jintai522/ME101_Wall-E/LINK TO ALL PARTS.txt

https://kb.vex.com/hc/en-us/articles/360044338912-CAD-Resources-for-VEX-IQ
