jintai522/ME101_Wall-E/PART LISTS.txt

https://www.vexrobotics.com/parts/228-7755?srsltid=AfmBOor7yfZhFB1WJDb23lGK7N8fuW8yRwTyhvqO8oEq8ajA6IASuBJW
