jintai522/ME101_Wall-E/Jintai Files/Scooperv1.SLDPRT

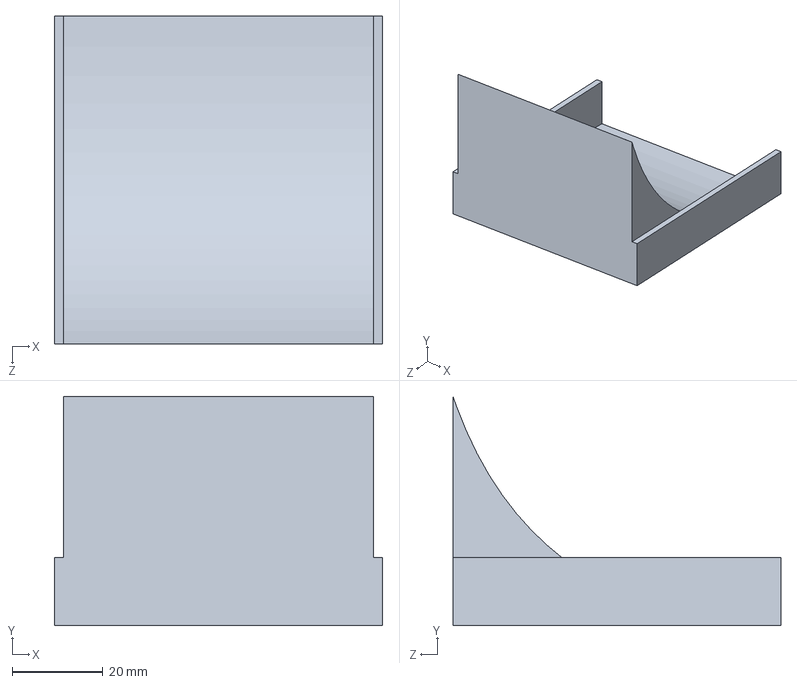
[picture p1: CAD file, 2026-07-04]
Jintai Files/Scooperv1.SLDPRT
72.2 x 50.5 x 72.2 mm
