jintai522/ME101_Wall-E/Jintai Files/straight bevel pinion_am11111.SLDPRT

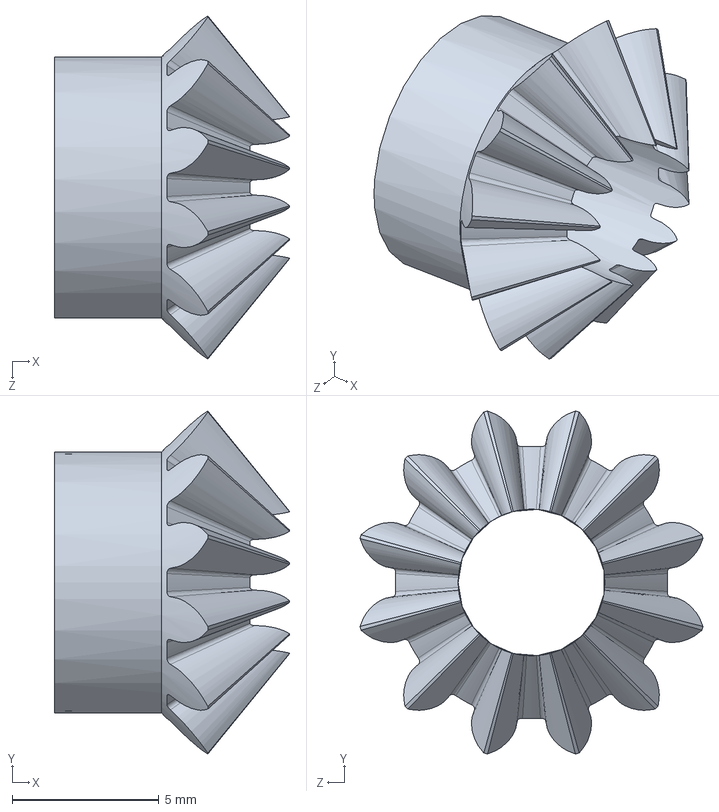
[picture p2: CAD file, 2026-07-04]
Jintai Files/straight bevel pinion_am11111.SLDPRT
8.03 x 11.7 x 11.7 mm
