jintai522/ME101_Wall-E/Jintai Files/box.SLDPRT

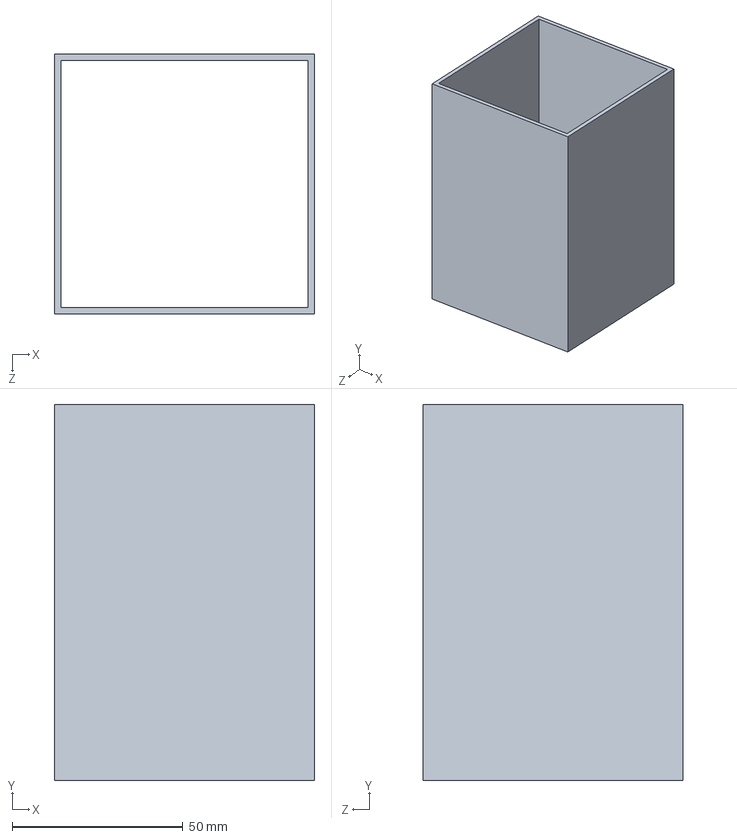
[picture p3: CAD file, 2026-07-01]
Jintai Files/box.SLDPRT
76.2 x 110.0 x 76.2 mm
