jintai522/ME101_Wall-E/Jintai Files/just arms.SLDASM

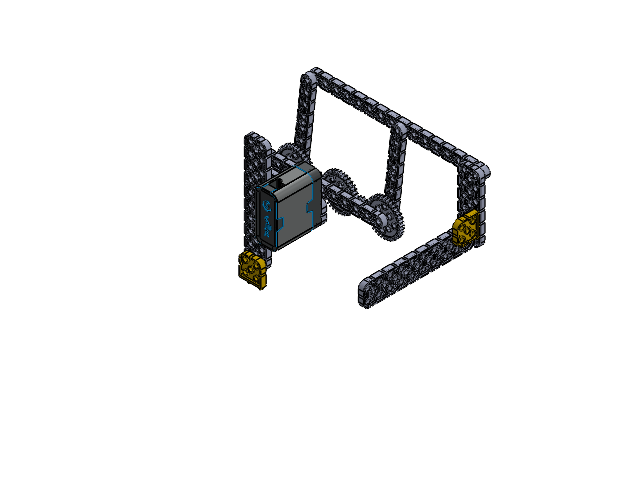
[picture p4: CAD file, 2026-07-08]
Jintai Files/just arms.SLDASM
1x12 Beam (228-2500-011).step
36 Tooth Gear (228-2500-214).step x 3
12 Tooth Gear (228-2500-213).step x 2
1x16 Beam (228-2500-014).step
2x6 Beam (228-2500-021).step x 2
1x8 Beam (228-2500-007).step x 2
2x Wide, 2x2 Corner Connector (Weak) (228-2500-2295).step x 2
2x10 Beam (228-2500-025).step x 2
VEX IQ Smart Motor (228-2560).step
