jintai522/ME101_Wall-E/Jintai Files/Vex+Gears+scooper+sidegear + arm - Copy.SLDASM

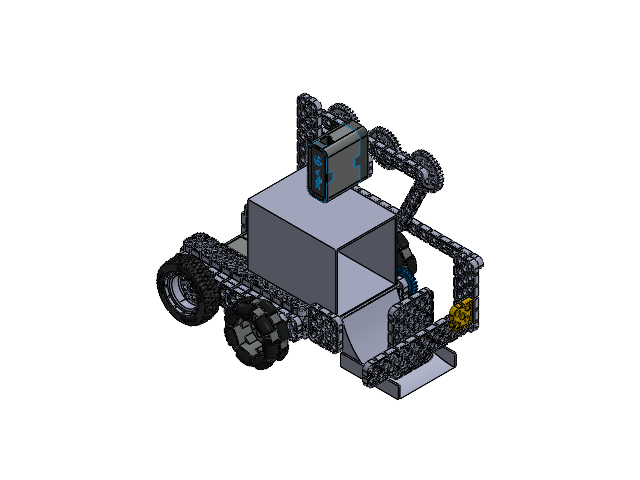
[picture p5: CAD file, 2026-07-08]
Jintai Files/Vex+Gears+scooper+sidegear + arm - Copy.SLDASM
2x12 Beam (228-2500-026).step x 4
Triple 2x Wide, 2x2 Corner Connector (228-2500-1253).step x 6
2x10 Beam (228-2500-025).step x 6
VEX IQ Smart Motor (228-2560).step x 4
2x6 Beam (228-2500-021).step x 3
Small Wheel Hub (44 mm) (228-2500-1208).step x 2
Tire (200 mm Travel) (228-2500-209).step x 2
228-2536-004-1.step x 28
228-2536-003-1.step x 28
228-2536-002-1.step x 28
228-2536-001-1.step x 2
2x2 Beam (228-2500-017).step x 2
VEX IQ Optical Sensor (228-7082).step x 2
2x Pitch Capped Shaft (228-2500-2219).step x 2
2x Wide, 2x2 Corner Connector (Weak) (228-2500-2295).step x 4
Scooperv1
3x3 Plate (228-2500-031).step x 2
12 Tooth Gear (228-2500-213).step x 4
24 Tooth Gear (228-2500-227).step
8x Pitch Capped Shaft (228-2500-2228).step
straight bevel pinion_am x 2
1x12 Beam (228-2500-011).step
36 Tooth Gear (228-2500-214).step x 3
1x16 Beam (228-2500-014).step
1x8 Beam (228-2500-007).step x 2
4x6 Plate (228-2500-042).step
