jintai522/ME101_Wall-E/Jintai Files/WALLE_BASE.SLDASM

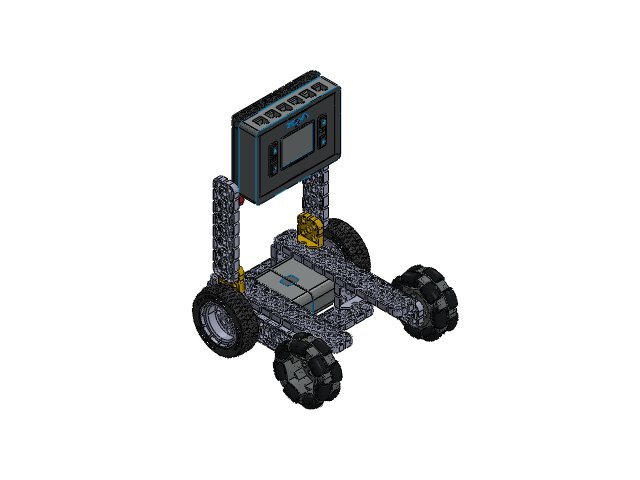
[picture p6: CAD file, 2026-07-06]
Jintai Files/WALLE_BASE.SLDASM
2x12 Beam (228-2500-026).step x 4
VEX IQ Smart Motor (228-2560).step x 2
Small Wheel Hub (44 mm) (228-2500-208).step x 2
Tire (200 mm Travel) (228-2500-209).step x 2
2x8 Beam (228-2500-023).step x 4
Triple 2x Wide, 2x2 Corner Connector (228-2500-1253).step x 4
2x Wide, 2x2 Corner Connector (Weak) (228-2500-2295).step x 2
228-2536-004-1.step x 14
228-2536-003-1.step x 14
228-2536-002-1.step x 14
228-2536-001-1.step
VEX IQ Robot Brain Gen 2 (228-6480).step
1x Wide, 1x1 Corner Connector (Weak) (228-2500-2288).step x 2
