jintai522/ME101_Wall-E/Jintai Files/justbasevex(rebuilt).SLDASM

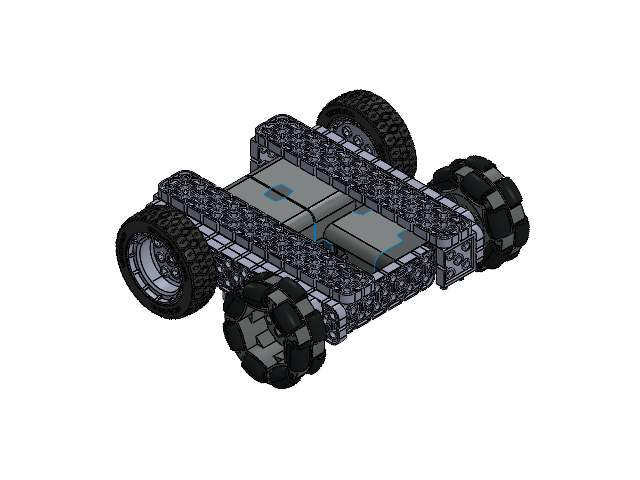
[picture p7: CAD file, 2026-07-04]
Jintai Files/justbasevex(rebuilt).SLDASM
2x12 Beam (228-2500-026).step x 4
Triple 2x Wide, 2x2 Corner Connector (228-2500-1253).step x 6
2x10 Beam (228-2500-025).step x 4
VEX IQ Smart Motor (228-2560).step x 3
2x6 Beam (228-2500-021).step
Small Wheel Hub (44 mm) (228-2500-1208).step x 2
Tire (200 mm Travel) (228-2500-209).step x 2
228-2536-004-1.step x 28
228-2536-003-1.step x 28
228-2536-002-1.step x 28
228-2536-001-1.step x 2
2x2 Beam (228-2500-017).step
VEX IQ Optical Sensor (228-7082).step
