jintai522/ME101_Wall-E/(list of files, cad)

Other CAD files:
Jintai Files/ROLLER-2_1.step.SLDASM
