jintai522/ME101_Wall-E/Design review 1 - Group #20.pdf

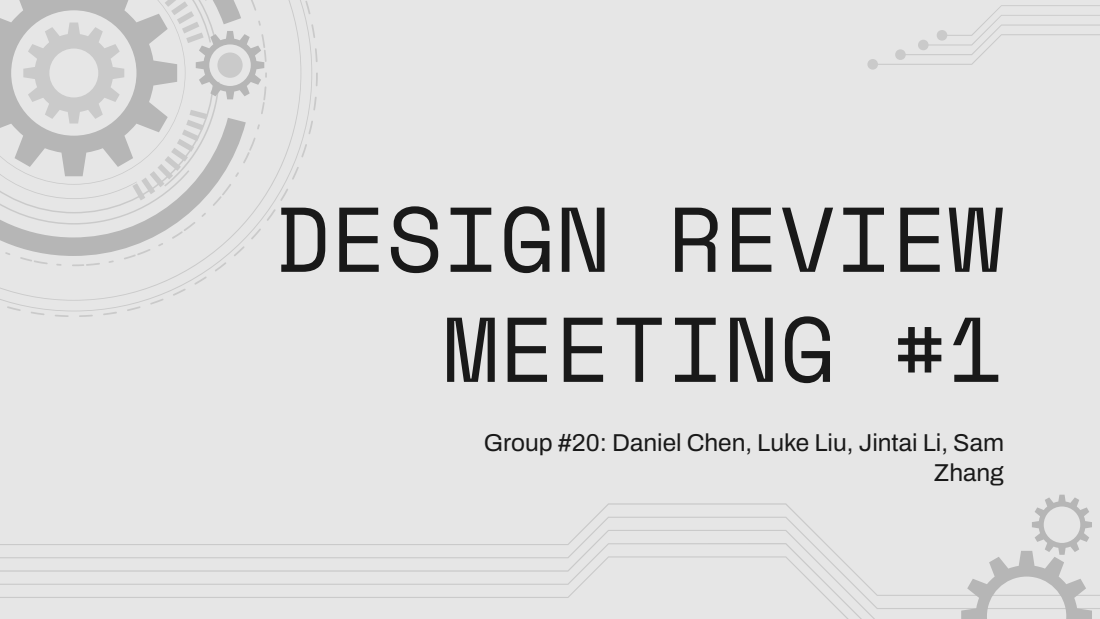
[picture p9: page 1]
DESIGN REVIEW MEETING #1; Zhang

Group #20: Daniel Chen, Luke Liu, Jintai Li, Sam

# TABLE OF CONTENTS

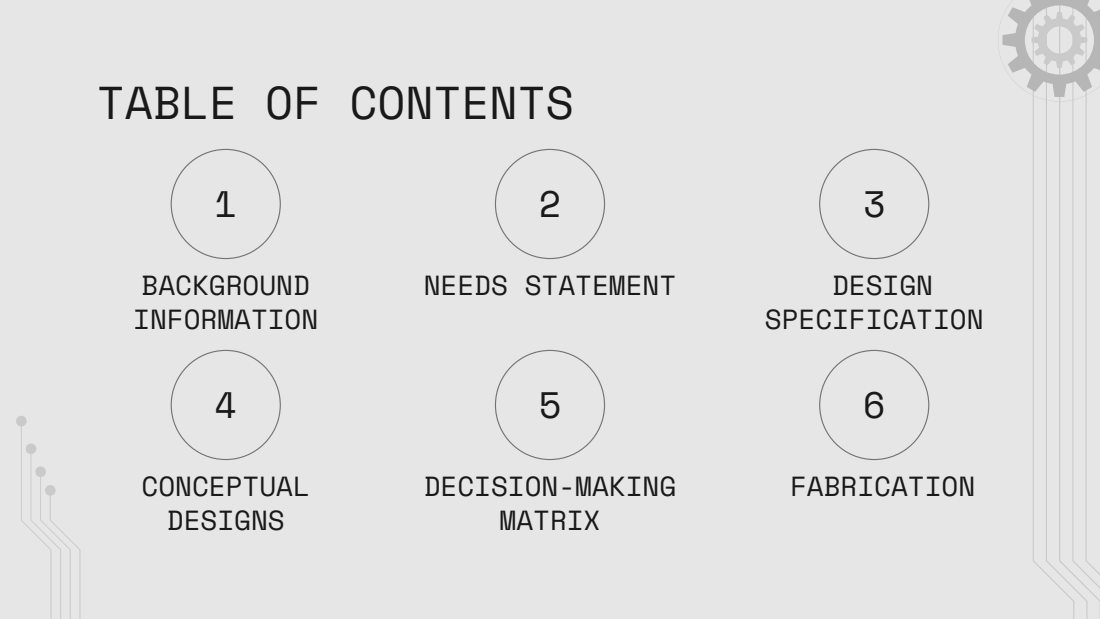
[picture p10: page 2]
BACKGROUND INFORMATION; NEEDS STATEMENT; CONCEPTUAL DESIGNS; DECISION-MAKING MATRIX; DESIGN SPECIFICATION; FABRICATION

# BACKGROUND INFORMATION

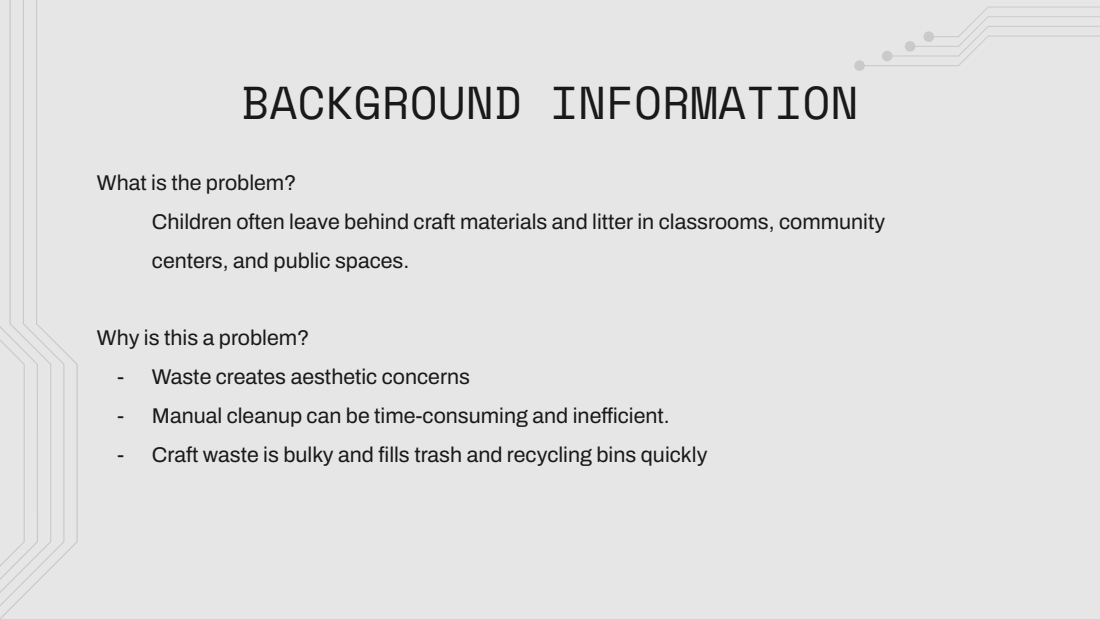
[picture p11: page 3]

What is the problem?
Children often leave behind craft materials and litter in classrooms, community
centers, and public spaces.

Why is this a problem?
- Waste creates aesthetic concerns
- Manual cleanup can be time-consuming and inefficient.
- Craft waste is bulky and fills trash and recycling bins quickly

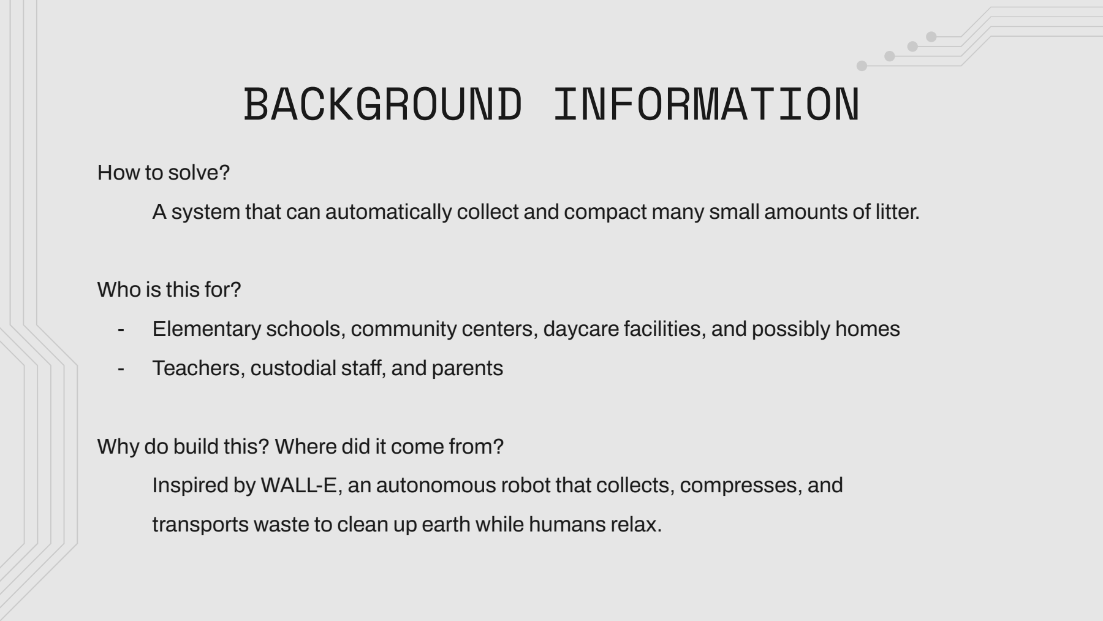
[picture p12: figure]
BACKGROUND INFORMATION; How to solve?; Who is this for?

A system that can automatically collect and compact many small amounts of litter.

- Elementary schools, community centers, daycare facilities, and possibly homes
- Teachers, custodial staff, and parents

Why do build this? Where did it come from?
Inspired by WALL-E, an autonomous robot that collects, compresses, and transports waste to clean up earth while humans relax.

# NEED STATEMENT

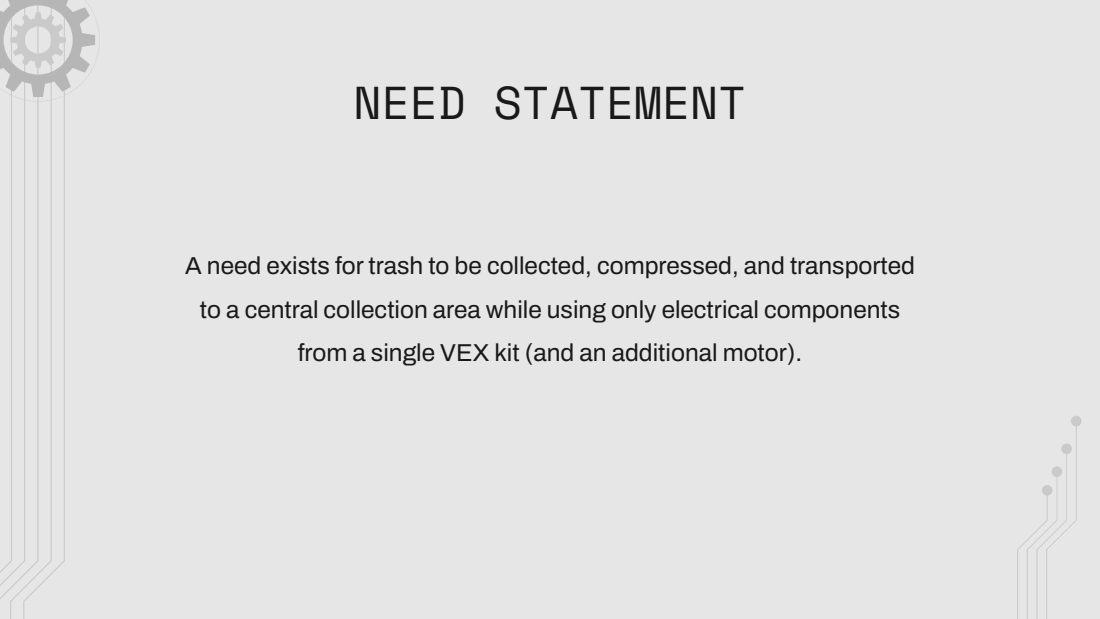
[picture p13: page 5]

A need exists for trash to be collected, compressed, and transported
to a central collection area while using only electrical components

from a single VEX kit (and an additional motor).

# DESIGN SPECIFICATIONS

No. | Characteristic | Relation | Value | Units | Verification Method | Comments
1 | Mass (Collected Trash) | >= | 10 | grams | Test | Trash will be scattered where the collected amount will be weighed on a scale.
2 | Volume reduction (After compression) | >= | 35 | % | Test | By measuring the width, length, and height of the cube before and after the compression, we can compare the volume of litter before and after and calculate % of volume reduced.
3 | Vote (Aesthetics) | >= | 70 | % | Test | Survey a minimum of 10 peers who have watched Wall-E and ask them if they can see the resemblance.
4 | Price | <= | 50 | CAD | Analysis | Calculate the total cost for the 3D printed parts (based on volume of model and cost per volume of filament), crafted parts, and bought parts.

# CONCEPTUAL DESIGNS

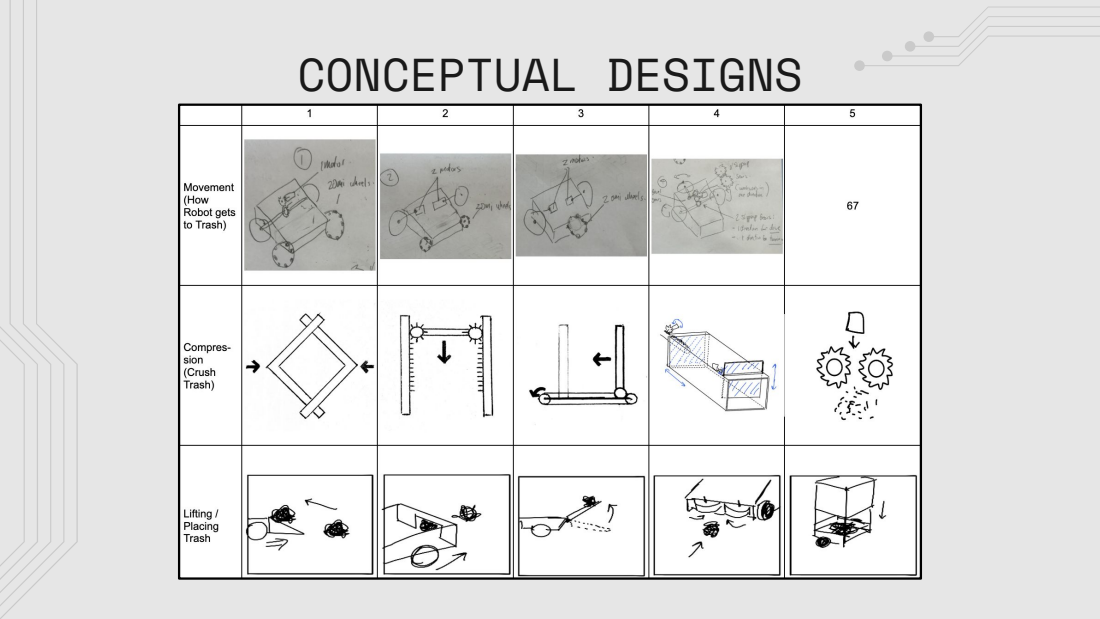
[picture p14: page 7]

# CONCEPTUAL DESIGNS (DATUM)

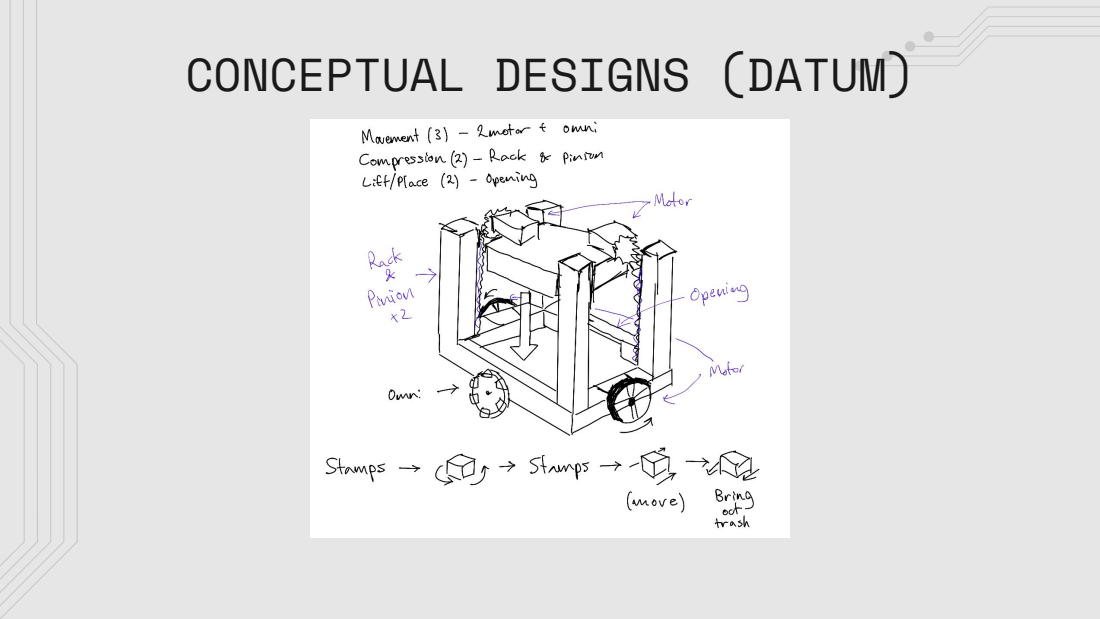
[picture p15: page 8]

# CONCEPTUAL DESIGNS #2

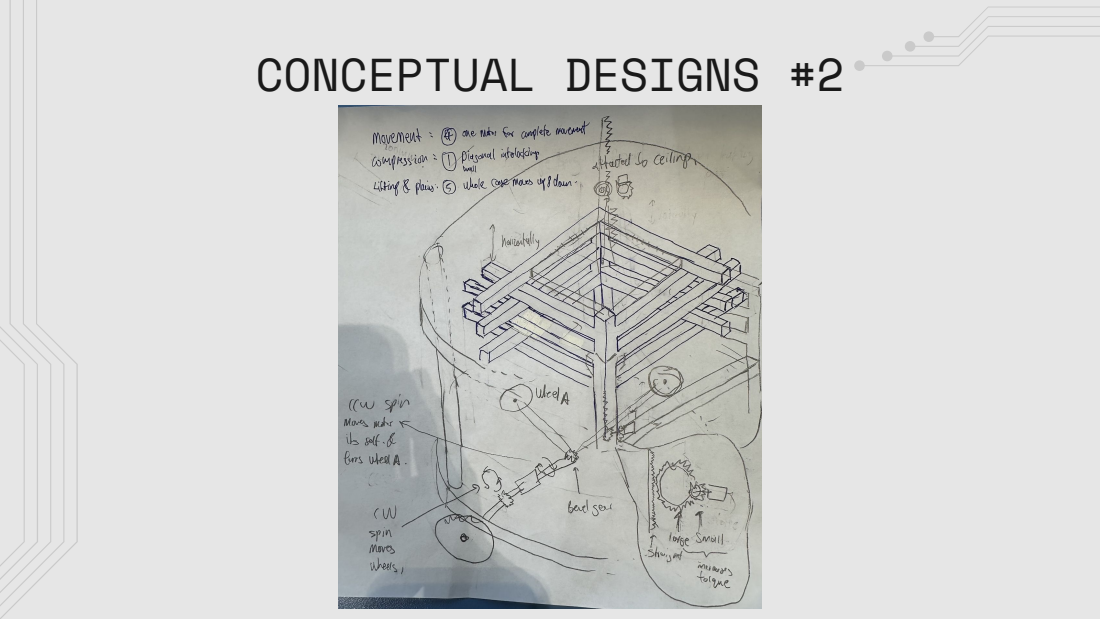
[picture p16: page 9]

# CONCEPTUAL DESIGNS #3

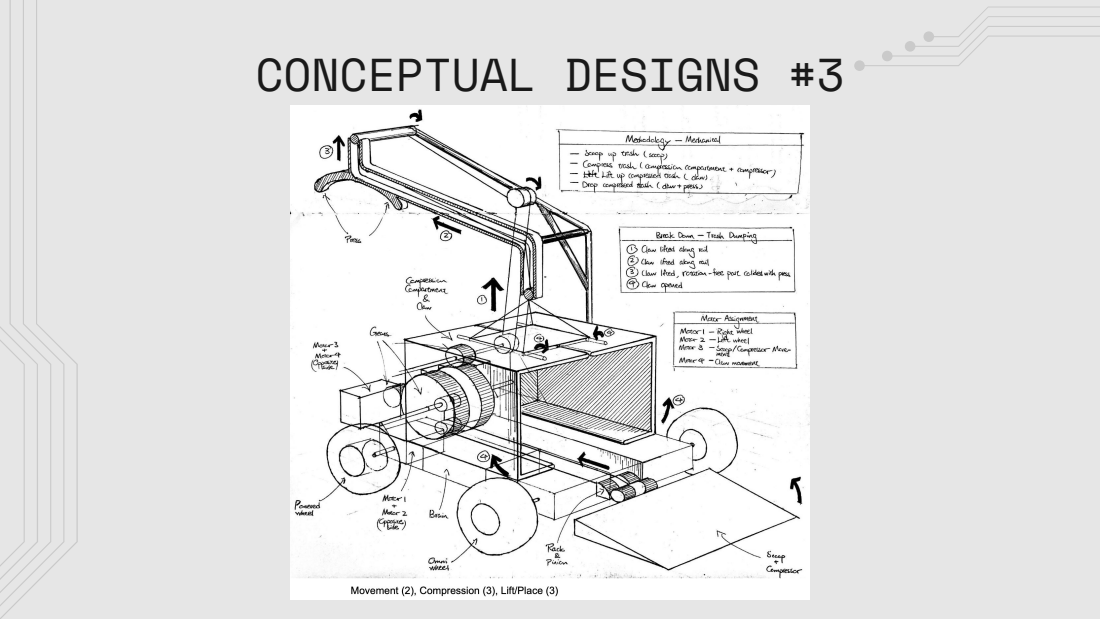
[picture p17: page 10]

# DECISION-MAKING MATRIX

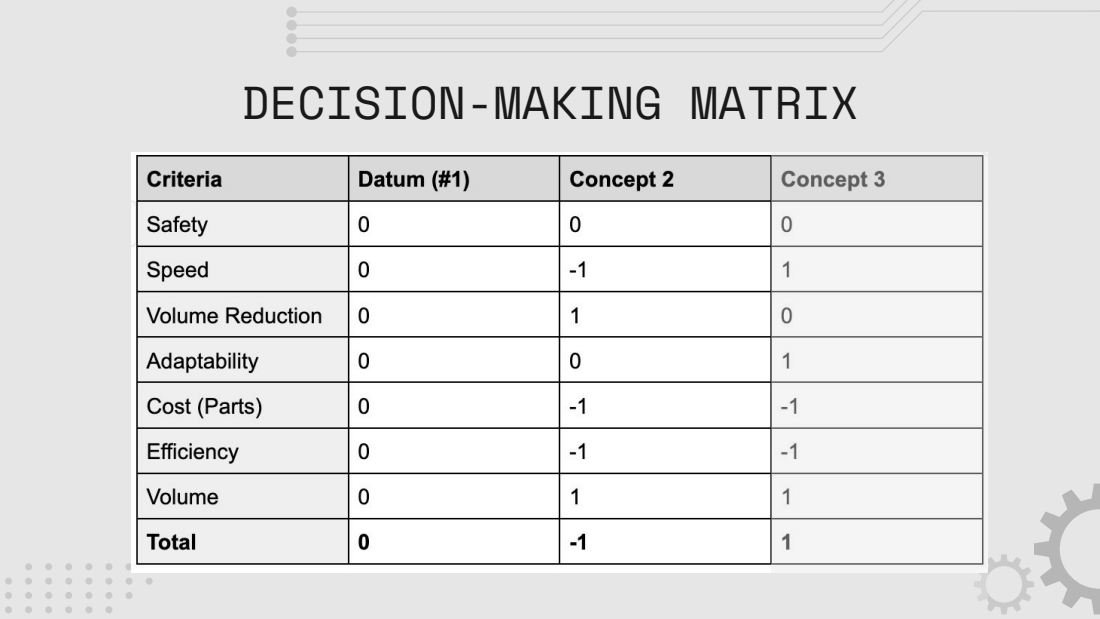
[picture p18: page 11]

# CONCEPTUAL DESIGNS #3

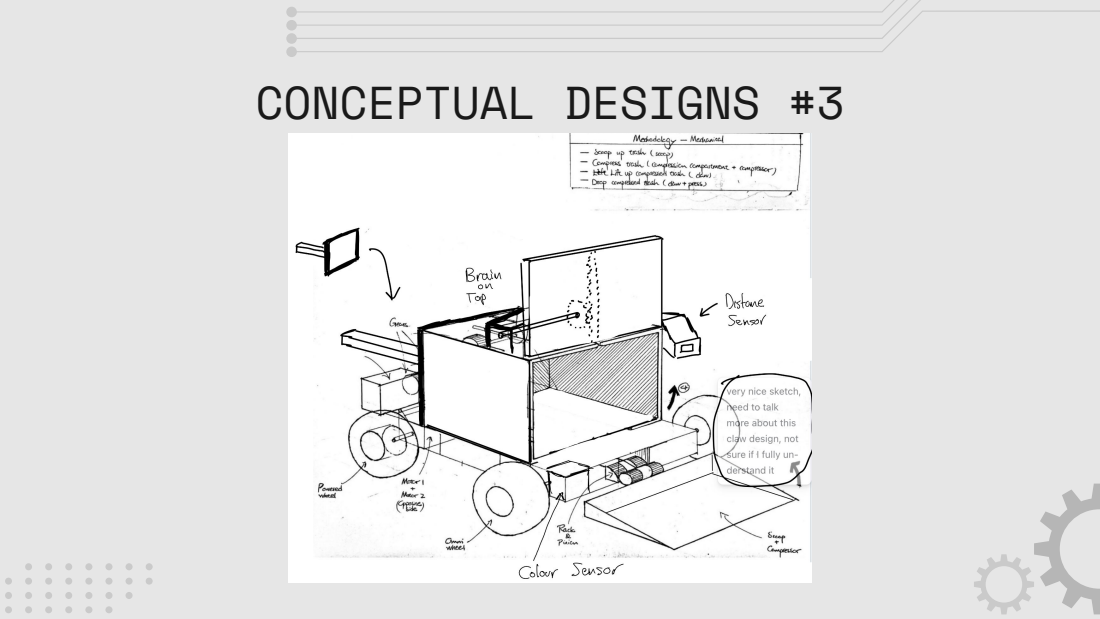
[picture p19: page 12]

# Fabrication

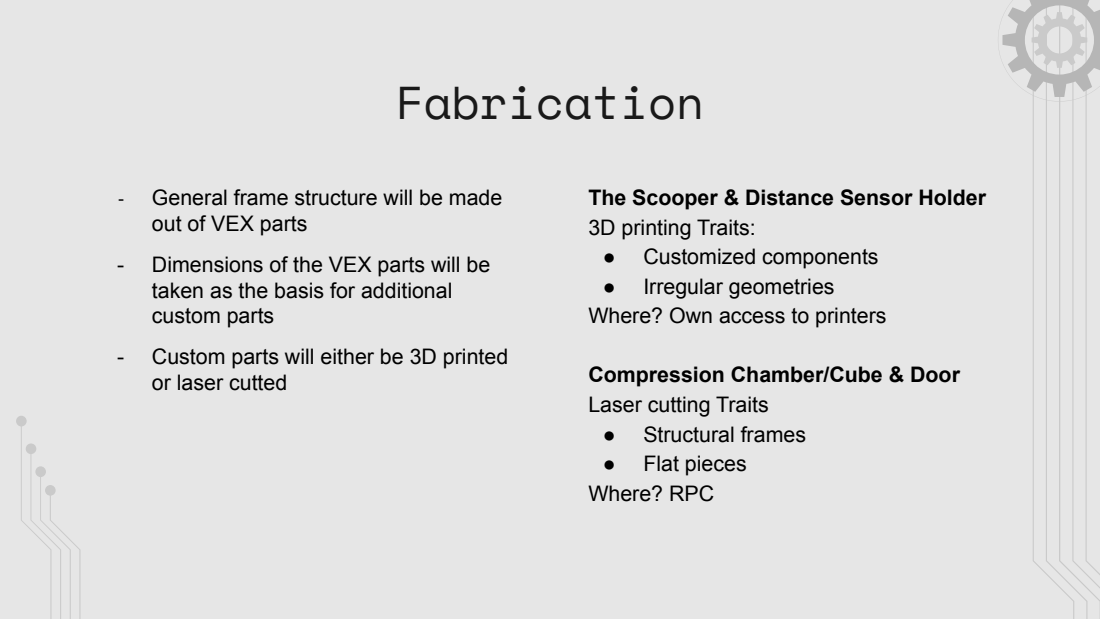
[picture p20: page 13]

- General frame structure will be made
out of VEX parts

The Scooper & Distance Sensor Holder
3D printing Traits:
● Customized components
● Irregular geometries
Where? Own access to printers

- Dimensions of the VEX parts will be
taken as the basis for additional
custom parts

- Custom parts will either be 3D printed
or laser cutted

Compression Chamber/Cube & Door
Laser cutting Traits
● Structural frames
● Flat pieces
Where? RPC

# Project Roadmap WBS Draft

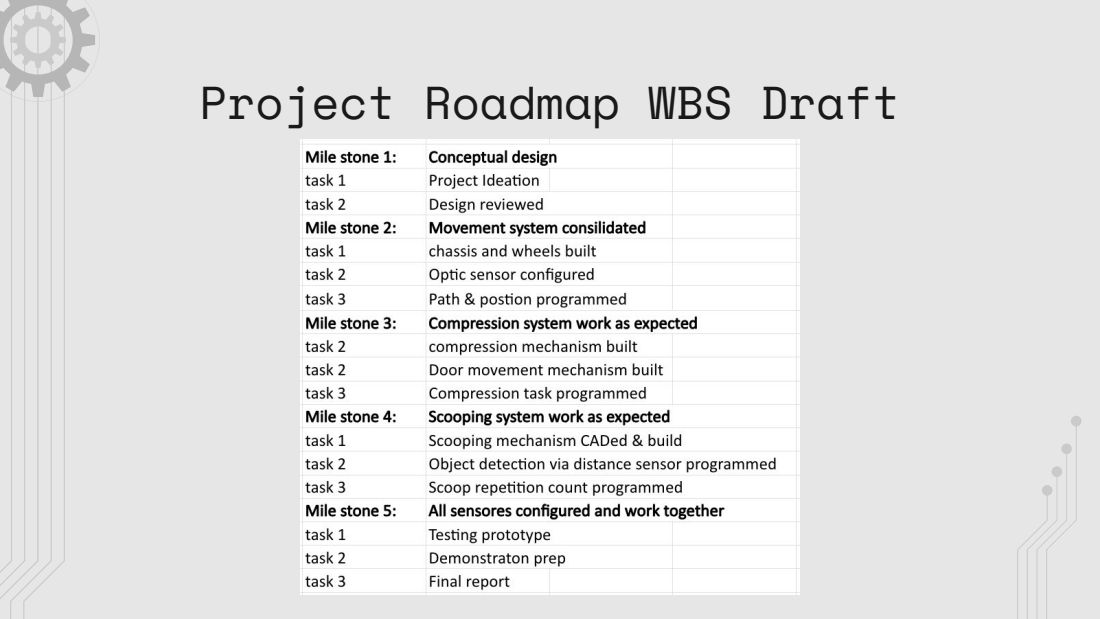
[picture p21: page 14]

# Project Roadmap Gantt Chart Draft

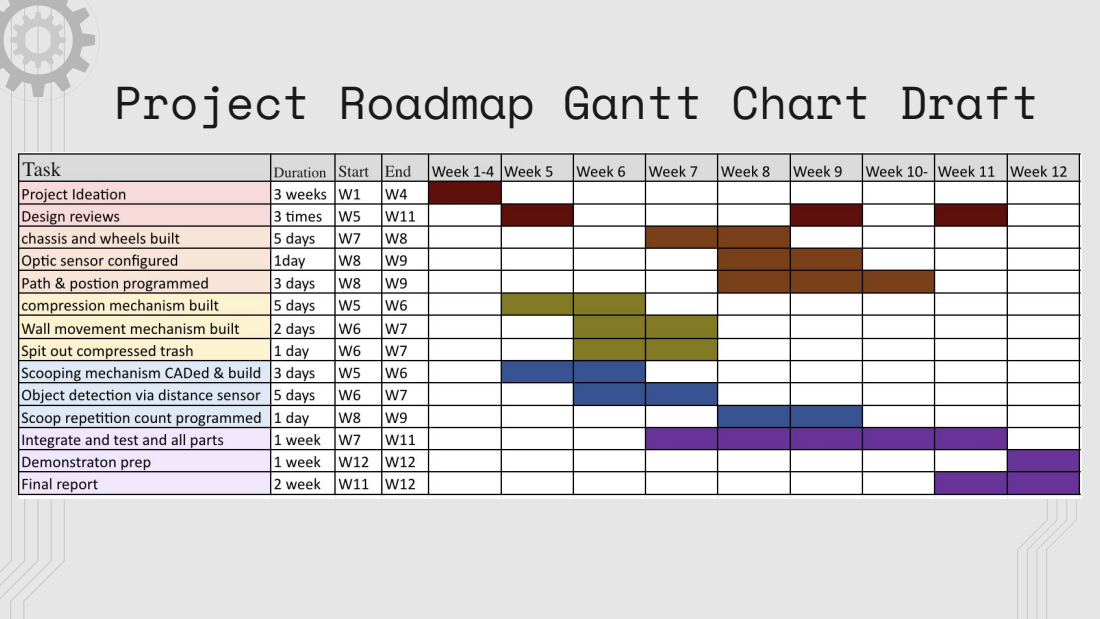
[picture p22: page 15]

# THANK YOU

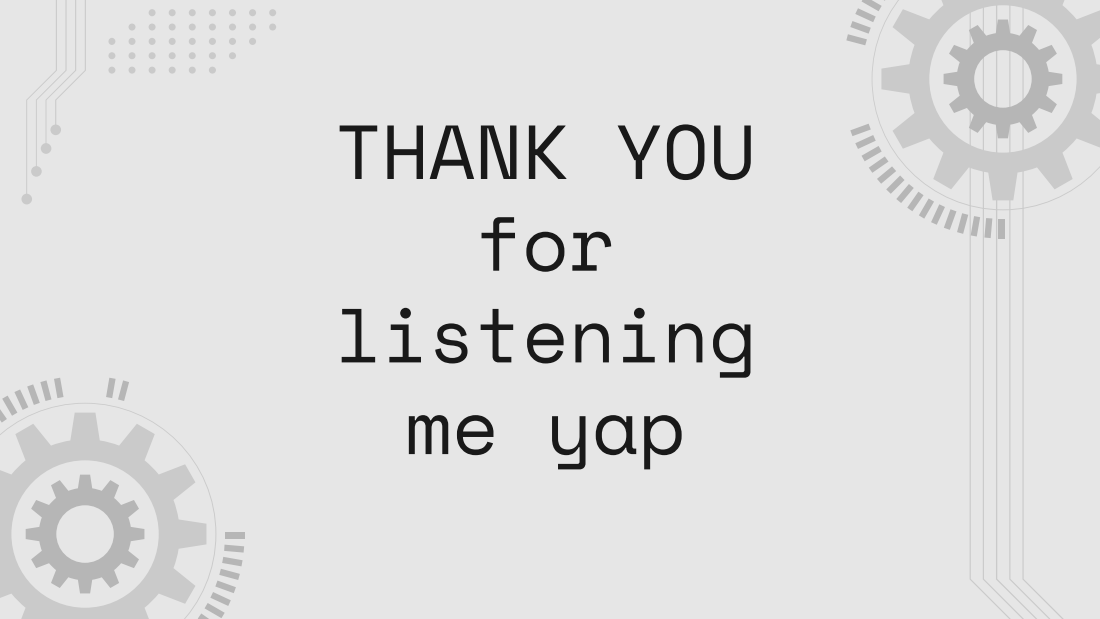
[picture p23: page 16]
for listening me yap

CREDITS: This presentation template was created
by Slidesgo, (https://bit.ly/3A1uf1Q) including icons by Flaticon (http://bit.ly/2TyoMsr) and
infographics & images by Freepik (http://bit.ly/2TtBDfr)
