jintai522/ME101_Wall-E/AutonomousRobotCode.cpp

#pragma region VEXcode Generated Robot Configuration
// Make sure all required headers are included.
#include <stdio.h>
#include <stdlib.h>
#include <stdbool.h>
#include <math.h>
#include <string.h>


#include "vex.h"

using namespace vex;

// Brain should be defined by default
brain Brain;


// START IQ MACROS
#define waitUntil(condition)                                                   \
  do {                                                                         \
    wait(5, msec);                                                             \
  } while (!(condition))

#define repeat(iterations)                                                     \
  for (int iterator = 0; iterator < iterations; iterator++)
// END IQ MACROS


// Robot configuration code.
inertial BrainInertial = inertial();
motor MotorDoor3 = motor(PORT3, false);
motor MotorCompress9 = motor(PORT9, false);
motor LeftMotor = motor(PORT7, false);
motor RightMotor = motor(PORT12, true);
distance Distance2 = distance(PORT2);
optical Optical11 = optical(PORT11);
motor Scooper8 = motor(PORT8, false);


// generating and setting random seed
void initializeRandomSeed(){
  wait(100,msec);
  double xAxis = BrainInertial.acceleration(xaxis) * 1000;
  double yAxis = BrainInertial.acceleration(yaxis) * 1000;
  double zAxis = BrainInertial.acceleration(zaxis) * 1000;
  // Combine these values into a single integer
  int seed = int(
    xAxis + yAxis + zAxis
  );
  // Set the seed
  srand(seed);
}

// Converts a color to a string
const char* convertColorToString(color col) {
  if (col == colorType::red) return "red";
  else if (col == colorType::green) return "green";
  else if (col == colorType::blue) return "blue";
  else if (col == colorType::white) return "white";
  else if (col == colorType::yellow) return "yellow";
  else if (col == colorType::orange) return "orange";
  else if (col == colorType::purple) return "purple";
  else if (col == colorType::cyan) return "cyan";
  else if (col == colorType::black) return "black";
  else if (col == colorType::transparent) return "transparent";
  else if (col == colorType::red_violet) return "red_violet";
  else if (col == colorType::violet) return "violet";
  else if (col == colorType::blue_violet) return "blue_violet";
  else if (col == colorType::blue_green) return "blue_green";
  else if (col == colorType::yellow_green) return "yellow_green";
  else if (col == colorType::yellow_orange) return "yellow_orange";
  else if (col == colorType::red_orange) return "red_orange";
  else if (col == colorType::none) return "none";
  else return "unknown";
}


void vexcodeInit() {

  // Initializing random seed.
  initializeRandomSeed();
}

#pragma endregion VEXcode Generated Robot Configuration
#include "iq_cpp.h"

/*
GROUP 20:
  Daniel Chen, Jintai Li
  Luke Liu, Sam Zhang
PROJECT:
  VEX-E
*/

using namespace vex;

// bump this string any time you want an easy way to confirm which version is loaded
// v18: compress() now pushes inward until current crosses COMPRESS_PUSH_CURRENT_THRESHOLD
// (adopted from Jintai's current-sensing compress) instead of a fixed degree target;
// goToDisposalBox() now uses a fixed turn/tape-crossing maneuver (adopted from Jintai's
// returning() idea) instead of odometry-vector navigation.
// v19: driveUntilGreen() now also checks for blue tape mid-search (seesBlueTape(),
// adopted from Jintai's BLUE_HUE_MIN/MAX) via disposalSignalDetect() -- seeing blue sets
// run_state = 4 to head back, same as finishing a compress. The disposal zone itself
// is still marked by red tape (driveUntilRed/seesRedTape, unchanged).
// v20: SLOWDOWN_START_FRACTION dropped from 0.80 to 0.70 -- eases back to 1x speed
// earlier in the row so there's more room to settle before the green tape.
// v21: compress()'s push-inward step was spinning past where the extend step started
// because spinCompressorUntilCurrent() had no degree cap -- now uses spinCompressorTo()
// again (degree AND current threshold) so it retracts/pushes the same |degree| (4000)
// as the extend step, not an unbounded spin waiting for a current spike.
// v22: full debug pass. Fixed pathFind()/goToDisposalBox() double-turning the heading
// when an object interrupts them mid-maneuver and they get resumed (a static guard now
// prevents the turn from re-running). Removed dead odometry code (posX/posY/trackMove/PI)
// left over from the goToDisposalBox rewrite -- it ran trig on every finishDrive() call
// for values nothing read anymore.
// v23: adopted Jintai's loop-back-to-search idea. goToDisposalBox() now calls
// returnToSearch() after dumpTrash() instead of ending the program (run_state = 0 is no
// longer reachable) -- it retraces the trip to the box in reverse using distances
// measured on the way there (lastCrossDistance/lastEdgeDistance) and resumes pathFind().
// v24: swapped in Jintai's scoopRobot strategy for scoopermove() -- distance-based legs
// instead of timed ones, a fast burst then an encoder-limited creep into the object,
// and a heading restore before reversing out (via new realignToIntendedHeading()).
// Compression is untouched and keeps this file's direction convention: MotorCompress9
// declared un-reversed, extend on `reverse`, push inward on `forward`. Jintai's file flips
// the motor declaration and so runs those the opposite way -- do not mix the two.
// driveForDuration() removed (scoopermove was its only caller).
// v25: BLUE_HUE_MAX 359 -> 260. It overlapped RED_HUE_MIN (340), so the red disposal
// tape satisfied seesBlueTape() as well as seesRedTape(). driveUntilRed() was fine (it
// only checks red), but disposalSignalDetect() runs on every step of the search loop,
// so passing near the red tape while searching falsely fired the go-home trigger.
// Also corrected the attribution in these comments: the teammate's code referred to
// throughout (COPY_PASTE_THIS_Sam_did_something.cpp, despite the filename) is Jintai's.
// v26: TEST BUILD -- compressor motion commented out inside spinCompressorTo() so the
// drive sequence (pathFind, scoop, goToDisposalBox, returnToSearch) can be watched on
// its own. Scooper, drivetrain, state machine and all timing are unchanged. NOT for a
// real run: nothing gets compressed or ejected, so the robot never actually empties.
// v27: TEST BUILD, continued. Scooper motion also disabled (new moveScooperTest(),
// used by scoopermove()'s lower/raise and dumpTrash()'s lower) -- it now never
// actually drops or lifts, only the drivetrain moves. This is drivetrain-only now:
// nothing in the whole cycle actuates except wheels.
// Also swapped the disposal-zone detection to Jintai's approach: goToDisposalBox()'s
// final leg now stops on a SECOND green tape instead of a dedicated red one --
// seesRedTape()/driveUntilRed()/RED_HUE_MIN/MAX/RED_BRIGHTNESS_MIN removed, since
// nothing else in the file used them.
// v28: driveUntilGreen() gained an allowFastRamp parameter. SLOWDOWN_START_FRACTION
// is a fraction of a full ROW's length, so on goToDisposalBox()'s shorter return-trip
// legs the robot never covered enough distance to trigger the ease-back before hitting
// the tape -- it stayed at FAST_MULTIPLIER (2x) the whole leg. Both return-trip calls
// now pass false and drive at normal PATH_SPEED; pathFind()'s row search passes true.
// v29: TEST BUILD, continued. Reworked the whole return trip. After compressing, the
// robot no longer continues forward in its approach heading (removed compress()'s
// clear-drive) -- it immediately turns toward the start column (same direction it
// already searched, away from any unscooped trash still ahead), drives a forced
// minimum SHIFT_DISTANCE, then drives until hitting the start-column edge. Red
// re-introduced (seesRedTape/RED_HUE_MIN/MAX/RED_BRIGHTNESS_MIN) to mark the actual
// dump-zone segment on that edge -- if the first contact is red, dump immediately and
// set hasSeenRed; if green, turn along the edge (right if hasSeenRed, left otherwise)
// and search it for red. New driveToStartEdge(); goToDisposalBox() now phase-tracked
// (0/1/2) so an object interruption mid-leg resumes correctly, matching the pattern
// already used elsewhere for this. returnToSearch() rewritten to retrace whichever
// legs this trip actually used, via new lastShiftEdgeDistance/lastAlongEdgeDistance/
// lastSearchTurnSign (replacing lastCrossDistance/lastEdgeDistance from v18).
// v30: TEST BUILD, continued. v29's return trip assumed the dump zone was on the
// same edge as the "turn toward already-covered ground" safety turn -- it wasn't;
// the dump zone is a fixed NE-corner spot (where the E wall meets the N wall, N =
// totalHeadingDeg 0). Replaced with a fixed absolute-heading trip: always face E
// (new rotateToAbsoluteHeading()) and drive to the E wall, then always face N and
// drive until red is found in the corner, then dump. No conditional turn direction
// or hasSeenRed memory needed anymore -- the destination is fixed, so the route is
// fixed too. Removed driveToStartEdge()/hasSeenRed/lastSearchTurnSign/
// lastShiftEdgeDistance/lastAlongEdgeDistance (v29, all wrong-wall). New
// preReturnHeading (captured in compress()) lets returnToSearch() restore whatever
// heading pathFind left off at, rather than reversing each turn individually.
// v31: TEST BUILD, continued. Red only runs along the N wall, not the E wall -- the E
// leg in goToDisposalBox() no longer checks for red (it physically can't be there),
// removing the "caught the corner early" early-dump branch that assumed otherwise.
// v32: TEST BUILD, continued. driveUntilGreen() -- used by pathFind()'s normal row
// search -- only ever checked seesGreenTape(), so a row ending on red (very possible
// starting near the NE corner, since red sits right there on the N wall) would never
// satisfy the loop condition and the robot would just keep driving into the wall.
// New seesBoundaryTape() (green OR red) is what the search loop checks now; red only
// means "the dump zone" once goToDisposalBox() is deliberately looking for it after a
// scoop -- during ordinary searching it's treated exactly like any other green crossing.
// v33: TEST BUILD, continued. returnToSearch()'s E-leg no longer reverses -- it now
// turns to face W (from wherever the N-leg reverse left it, still facing N) and
// drives forward the rest of the way back toward the row, instead of continuing to
// back up the whole trip. The N-leg (backing straight out of the dump zone, still
// facing N) is unchanged.
const char* CODE_VERSION = "v33-TEST-eleg-faces-travel-direction";

const double WHEEL_C = 200; //mm

const double ROTATE_KP = 1.8;
const double STRAIGHT_KP = 2;

const double SCOOPSPEED = 10; // scooper speed for dumpTrash (the scoop routine has its own below)

// scoop routine, adopted from Jintai's scoopRobot: distance-based moves instead of
// timed ones, a short fast burst into the object rather than three timed stages,
// and a heading restore afterwards
const double SCOOP_BACKUP_DISTANCE = 250;   // mm to reverse before dropping the scooper
const double SCOOP_APPROACH_DISTANCE = 400; // mm to cover driving into the object
const double SCOOP_BURST_SECONDS = 1.5;     // seconds of full-speed approach before easing off
const int SCOOP_BURST_SPEED = 90;           // percent for that burst
const int SCOOP_CREEP_SPEED = 45;           // percent for the rest of the approach
const double SCOOP_BACKOUT_DISTANCE = 400;  // mm to reverse back out once the scooper is up
const int SCOOP_DRIVE_SPEED = 30;           // percent for the backup and backout legs
const int SCOOP_LOWER_SPEED = 30;           // percent, scooper down
const double SCOOP_LOWER_SECONDS = 1.2;
const int SCOOP_RAISE_SPEED = 47;           // percent, scooper up
const double SCOOP_RAISE_SECONDS = 1;

const double COMPRESS_DEGREE = -4000;
const int COMPRESS_SPEED = 75;
const double COMPRESS_CURRENT_MAX = 0.9;
const double COMPRESS_PUSH_CURRENT_THRESHOLD = 0.4; // amps; push-inward stops once current crosses this (Jintai's idea) instead of a fixed degree

const double SHIFT_DISTANCE = 250; // mm, small lateral step between rows, not another full row
const int PATH_SPEED = 45; // 30 * 1.5
const double TURN_ANGLE = 90;      // degrees; flip sign below if left/right come out reversed
const double SCOOP_DETECT_MIN = 10;  // mm; tune both of these while watching real detections
const double SCOOP_DETECT_MAX = 60;  // mm; 150 was catching the ground since the sensor sits slightly angled down
const int STOP_RAMP_STEP = 10;    // percent power dropped per ramp step when easing to a stop
const int STOP_RAMP_DELAY = 30;   // msec between ramp steps
const double FAST_MULTIPLIER = 2.0; // speed multiplier once the row length is known
const double SLOWDOWN_START_FRACTION = 0.70; // slow back to 1x once this fraction of the known length is covered
const double GREEN_HUE_MIN = 75;     // degrees; widen/narrow this range while watching the live readout
const double GREEN_HUE_MAX = 160;
const double GREEN_BRIGHTNESS_MIN = 15; // percent; lower if tape never registers, raise if false triggers
const double RED_HUE_MIN = 340;      // degrees; red wraps around 0, so this is a two-sided range (>=340 or <=20)
const double RED_HUE_MAX = 20;       // marks the dump-zone segment on the start-column edge (see goToDisposalBox)
const double RED_BRIGHTNESS_MIN = 15; // percent; tune the same way as GREEN_BRIGHTNESS_MIN
const double BLUE_HUE_MIN = 190;     // degrees; the blue return-signal tape (Jintai's idea)
const double BLUE_HUE_MAX = 260;     // kept below RED_HUE_MIN (340) so red can't satisfy seesBlueTape() --
                                     // real blue sits around 210-250, so this still has margin
const double BLUE_BRIGHTNESS_MIN = 15; // percent; tune the same way as GREEN_BRIGHTNESS_MIN
const int STATUS_REFRESH_INTERVAL = 10; // loop iterations between screen redraws

motor_group driveMotor(LeftMotor,RightMotor);

// heading reference, relative to the robot's starting orientation (never reset mid-run)
double totalHeadingDeg = 0;

// the field's length varies box to box, so this is measured the first time a
// row is driven cleanly end-to-end (green tape to green tape), not hardcoded
double fieldLength = 0;
bool fieldLengthKnown = false;

int lastTurnSign = -1; // direction of the most recent pathFind row-shift turn (pathFind's own bookkeeping;
                        // goToDisposalBox no longer needs this -- its return heading is now fixed, not relative)

// the field is a rectangular green border with a red segment (the dump zone) in the
// NE corner, where the E wall meets the N wall (N = totalHeadingDeg 0, i.e. row 0's
// original heading). The return trip is a fixed heading sequence -- always face E,
// then always face N -- since the dump zone's location is fixed and known in advance.
double preReturnHeading = 0; // totalHeadingDeg captured right when compress() finishes, before any
                              // return-trip turning -- restored at the end of returnToSearch() so pathFind
                              // resumes at whatever heading it left off at, whether that was mid-row or mid-shift

// distances measured during the most recent trip to the disposal box, so
// returnToSearch() can retrace the same trip in reverse instead of needing real odometry
double lastEastLegDistance = 0;  // facing E: from the compress spot to the E wall
double lastNorthLegDistance = 0; // facing N: from the E wall to the red dump zone in the NE corner

double normalizeAngle(double angle)
{
  while (angle > 180) angle -= 360;
  while (angle < -180) angle += 360;
  return angle;
}

double traveledDistance()
{
  return (fabs(LeftMotor.position(turns)*WHEEL_C)+fabs(RightMotor.position(turns)*WHEEL_C))/ 2.0;
}

void driveStep(double speed)
  // speed can be negative to drive in reverse -- still heading-corrected either way
{
  // correct toward totalHeadingDeg (the true expected heading for the whole run)
  // instead of "0" -- the inertial sensor is never reset mid-run anymore, so
  // this is a real absolute reference instead of "whatever I was facing when
  // this leg started," which is what let misalignment quietly compound before.
  double heading = BrainInertial.rotation(degrees);
  double error = totalHeadingDeg - heading;
  double correction = STRAIGHT_KP * error;

  double leftPower = speed + correction;
  double rightPower = speed - correction;

  LeftMotor.spin((leftPower >= 0) ? forward : reverse, fabs(leftPower), percent);
  RightMotor.spin((rightPower >= 0) ? forward : reverse, fabs(rightPower), percent);
}

void finishDrive(double fromSpeed)
  // eases to a stop instead of slamming the brake -- an abrupt full-brake
  // stop (especially from the faster 2x search speed) was what caused the
  // wobble/misalignment right as an object was detected
{
  double p = fromSpeed;
  while (fabs(p) > STOP_RAMP_STEP)
  {
    p = (p > 0) ? p - STOP_RAMP_STEP : p + STOP_RAMP_STEP;
    driveStep(p);
    wait(STOP_RAMP_DELAY, msec);
  }
  driveMotor.stop(brake);
}

void configureAllSensors()
{
  Brain.Screen.print("Calibrating...");
  BrainInertial.calibrate();
  while (BrainInertial.isCalibrating())
  {}
  Brain.Screen.clearScreen();
  Brain.Screen.setCursor(1,1);
  BrainInertial.resetRotation();
  Optical11.setLight(ledState::on);
}
/*
PID Sources
https://www.youtube.com/watch?v=KMSJviT2jI8
https://lucykim0907-byte.github.io/Pid-build-log-by-Jaehyeon-Shin/pid_portfolio.html
P is the proportional, which is error
  (how far off)
*/
void rotateRobot(double targetAngle, int speed)
{
  double error = 676; // change if needed
  double startAngle = BrainInertial.rotation(degrees);
  double targetAbsolute = startAngle + targetAngle;
  while (fabs(error) > 0.3) // get at 0.3 degree of target
  {
    double currentAngle = BrainInertial.rotation(degrees);
    error = targetAbsolute - currentAngle;

    double power = ROTATE_KP * error;
    if (power > speed)
    {
      power = speed;
    }
    else if (power < -speed)
    {
      power = -speed;
    }

    if (power > 0 and power < 5)
    {
      power = 5;
    }
    else if (power < 0 and power > -5)
    {
      power = -5;
    }

    if (power > 0)
    {
      LeftMotor.spin(forward, power, percent);
      RightMotor.spin(reverse, power, percent);
    }
    else if (power < 0)
    {
      double absPower = -power;
      LeftMotor.spin(reverse, absPower, percent);
      RightMotor.spin(forward, absPower, percent);
    }
    else
    {
      driveMotor.stop(brake);
    }
  }
  driveMotor.stop(brake);

  // motor momentum can carry the robot past the target after stop(brake) fires;
  // settle briefly, then apply small corrective nudges with a lower power floor
  // so it actually lands on the target instead of just reading close at the
  // instant the main loop's speed-5 minimum told it to stop
  wait(100, msec);
  int correctionAttempts = 0;
  error = targetAbsolute - BrainInertial.rotation(degrees);
  while (fabs(error) > 0.3 and correctionAttempts < 10)
  {
    double correctionPower = (error > 0) ? 3 : -3;
    if (correctionPower > 0)
    {
      LeftMotor.spin(forward, correctionPower, percent);
      RightMotor.spin(reverse, correctionPower, percent);
    }
    else
    {
      LeftMotor.spin(reverse, -correctionPower, percent);
      RightMotor.spin(forward, -correctionPower, percent);
    }
    wait(30, msec);
    driveMotor.stop(brake);
    wait(50, msec);
    error = targetAbsolute - BrainInertial.rotation(degrees);
    correctionAttempts++;
  }

  // kept unwrapped (not normalized) so it stays on the same raw scale as
  // BrainInertial.rotation(degrees), which is also never reset mid-run and
  // therefore never wraps either -- normalizeAngle is only applied to
  // differences of this value elsewhere, never to the value itself
  totalHeadingDeg = totalHeadingDeg + targetAngle;
}

void rotateToAbsoluteHeading(double targetHeading, int speed)
  // turns to a fixed heading (0 = N, 90 = E, ...) relative to totalHeadingDeg's own
  // zero, rather than a relative angle from wherever the robot currently is. Used by
  // goToDisposalBox()'s fixed E-then-N return trip: since the target heading doesn't
  // depend on which direction the robot happened to be facing when it stopped to
  // scoop, calling this again after an interruption just does a near-zero correction
  // instead of turning again -- no separate "already turned" guard needed.
{
  double delta = normalizeAngle(targetHeading - totalHeadingDeg);
  rotateRobot(delta, speed);
}

void snapHeadingToGrid()
  // re-anchors heading drift against the tape itself: corrects to the nearest
  // 90-degree multiple, since the field's rows are expected to run exactly
  // perpendicular to the tape lines. Run this every time tape is reached so
  // small errors get corrected instead of silently carrying into the next row.
{
  double nearestGrid = round(totalHeadingDeg / 90.0) * 90.0;
  double correction = normalizeAngle(nearestGrid - totalHeadingDeg);

  if (fabs(correction) > 0.5)
  {
    rotateRobot(correction, PATH_SPEED);
  }
}

void realignToIntendedHeading(int speed)
  // pulls the robot back onto totalHeadingDeg after a manoeuvre that knocked it
  // off, adopted from Jintai's capture-heading-then-restore trick in scoopRobot.
  //
  // totalHeadingDeg must NOT move here -- this is undoing drift, not commanding a
  // turn, and the intended heading hasn't changed. rotateRobot() always adds its
  // angle to totalHeadingDeg (it assumes a deliberate turn), so that gets undone.
{
  double drift = normalizeAngle(totalHeadingDeg - BrainInertial.rotation(degrees));
  if (fabs(drift) < 0.5) return;

  rotateRobot(drift, speed);
  totalHeadingDeg -= drift;
}

void showStatusLine1(const char* text)
{
  Brain.Screen.setCursor(1,1);
  Brain.Screen.clearLine(1);
  Brain.Screen.print("%s", text);
}

void showSensorReadout(double hue, double brightness, color col)
{
  static int sampleCount = 0;

  // throttle the readout so the screen redraw doesn't slow down sensing
  if (sampleCount % STATUS_REFRESH_INTERVAL == 0)
  {
    Brain.Screen.setCursor(2,1);
    Brain.Screen.clearLine(2);
    Brain.Screen.print("hue %.0f bright %.0f", hue, brightness);
    Brain.Screen.setCursor(3,1);
    Brain.Screen.clearLine(3);
    Brain.Screen.print("color: %s", convertColorToString(col));
  }
  sampleCount++;
}

bool scoopDetect(double min, double max, int & run_state)
{
  if(Distance2.objectDistance(mm) < max and Distance2.objectDistance(mm) > min)
  {
    showStatusLine1("Object Detected");
    run_state = 2;
    return true;
  }
  else
  {
    return false;
  }
}

void moveScooperTest(directionType dir, int speed, double durationSeconds)
  // ***** SCOOPER DISABLED -- MOVEMENT-ONLY TEST BUILD *****
  // spin/stop commented out so the scooper never actually raises or lowers while
  // the drivetrain sequence is being watched. The wait still runs, so overall
  // timing matches what a normal cycle would take.
  //
  // TO RE-ENABLE: delete the printf line, uncomment the block under it, and bump
  // CODE_VERSION off the "TEST" name so the brain screen stops advertising this.
{
  printf("SCOOPER SKIPPED (disabled) dir=%s speed=%d seconds=%.2f\n",
         (dir == forward) ? "forward" : "reverse", speed, durationSeconds);
  wait(durationSeconds, seconds);

  /*
  Scooper8.spin(dir, speed, percent);
  wait(durationSeconds, seconds);
  Scooper8.stop();
  */
}

void scoopermove (int & run_state)
  // Jintai's scoopRobot strategy: back off a measured distance, drop the scooper,
  // charge in with a short full-speed burst then ease the rest of the way on
  // encoder distance, lift, straighten up, and reverse back out.
  //
  // Distance-based rather than timed, so a low battery or a heavy load changes
  // how long it takes but not how far it goes -- the old timed version quietly
  // travelled a different distance every run.
  //
  // The drive legs use driveStep so they stay heading-corrected (this file's
  // convention), which Jintai's raw driveMotor.spin calls don't do.
{
  driveBlind(SCOOP_BACKUP_DISTANCE, -SCOOP_DRIVE_SPEED);
  wait(0.5, seconds);

  moveScooperTest(forward, SCOOP_LOWER_SPEED, SCOOP_LOWER_SECONDS);

  wait(0.5, seconds);

  LeftMotor.resetPosition();
  RightMotor.resetPosition();

  // full-speed burst to get the scooper under the object, distance-capped so a
  // fast run can't blow straight past the target (Jintai's is purely timed)
  double burstEnd = Brain.timer(seconds) + SCOOP_BURST_SECONDS;
  while (Brain.timer(seconds) < burstEnd and traveledDistance() < SCOOP_APPROACH_DISTANCE)
  {
    driveStep(SCOOP_BURST_SPEED);
  }
  while (traveledDistance() < SCOOP_APPROACH_DISTANCE)
  {
    driveStep(SCOOP_CREEP_SPEED);
  }
  finishDrive(SCOOP_CREEP_SPEED);

  moveScooperTest(reverse, SCOOP_RAISE_SPEED, SCOOP_RAISE_SECONDS);

  // the scoop shoves the robot around, so straighten up before reversing out
  realignToIntendedHeading(PATH_SPEED);
  driveBlind(SCOOP_BACKOUT_DISTANCE, -SCOOP_DRIVE_SPEED);

  run_state = 3;
}




void straightDrive(double distance, int speed,int & run_state)
{
  LeftMotor.resetPosition();
  RightMotor.resetPosition();

  while (traveledDistance() < distance and !(scoopDetect(SCOOP_DETECT_MIN,SCOOP_DETECT_MAX,run_state)))
  {
    driveStep(speed);
  }
  finishDrive(speed);
}

void userInter(int & run_state)
{
  Brain.Screen.clearScreen();
  Brain.Screen.setCursor(1,1);
  if (run_state == 1) Brain.Screen.print("Searching");
  else if (run_state == 2) Brain.Screen.print("Scooping");
  else if (run_state == 3) Brain.Screen.print("Compressing");
  else if (run_state == 4) Brain.Screen.print("Heading to disposal box");
  else if (run_state == 0) Brain.Screen.print("Finished");
}

bool seesGreenTape()
{
  double hue = Optical11.hue();
  double brightness = Optical11.brightness();
  bool isGreen = (hue >= GREEN_HUE_MIN and hue <= GREEN_HUE_MAX and brightness > GREEN_BRIGHTNESS_MIN);

  showSensorReadout(hue, brightness, Optical11.color());
  if (isGreen) showStatusLine1("Green Tape Detected");

  return isGreen;
}

bool seesRedTape()
  // marks the dump-zone segment on the start-column edge -- see goToDisposalBox()
{
  double hue = Optical11.hue();
  double brightness = Optical11.brightness();
  bool isRed = (hue >= RED_HUE_MIN or hue <= RED_HUE_MAX) and brightness > RED_BRIGHTNESS_MIN;

  showSensorReadout(hue, brightness, Optical11.color());
  if (isRed) showStatusLine1("Red Tape Detected");

  return isRed;
}

bool seesBoundaryTape()
  // true on green almost everywhere, OR red where a row happens to end on the
  // dump-zone segment of the N wall. During normal searching (not yet carrying
  // anything to dump), red means nothing special here -- it's just where this
  // particular row's boundary happens to be, same as any other crossing.
{
  return seesGreenTape() or seesRedTape();
}

bool seesBlueTape()
  // a signal encountered while searching -- seeing it means "head back to the
  // disposal zone now," adopted from Jintai's seesColor(BLUE_HUE_MIN, BLUE_HUE_MAX, ...)
  // check inside his driveUntilGreen(). Red (seesRedTape) is what actually marks the
  // dump zone itself -- blue is just the trigger to go look for it.
{
  double hue = Optical11.hue();
  double brightness = Optical11.brightness();
  bool isBlue = (hue >= BLUE_HUE_MIN and hue <= BLUE_HUE_MAX) and brightness > BLUE_BRIGHTNESS_MIN;

  showSensorReadout(hue, brightness, Optical11.color());
  if (isBlue) showStatusLine1("Blue Tape Detected");

  return isBlue;
}

bool disposalSignalDetect(int & run_state)
  // checked during searching -- if blue tape is seen, stop searching and head to the
  // disposal zone (goToDisposalBox will navigate to the red tape from there)
{
  if (seesBlueTape())
  {
    run_state = 4;
    return true;
  }
  return false;
}

void driveUntilGreen(int speed, int & run_state, bool allowFastRamp)
  // despite the name, stops on green OR red (seesBoundaryTape) -- red only means
  // "the dump zone" once something's actually been scooped and goToDisposalBox() is
  // deliberately looking for it; during ordinary searching it's just where this row's
  // boundary happens to be, and is treated exactly like green (see seesBoundaryTape).
  //
  // allowFastRamp gates the 2x speed-up below. It only makes sense while pathFind()
  // is searching full rows -- SLOWDOWN_START_FRACTION is a fraction of a whole row's
  // length, so on the shorter return-trip legs in goToDisposalBox() the robot never
  // travels far enough to trigger the ease-back before hitting the tape, and stays
  // at 2x the entire leg. Callers on the return trip pass false to just drive at
  // normal speed instead.
{
  LeftMotor.resetPosition();
  RightMotor.resetPosition();

  // first pass: fieldLength isn't known yet, so just drive at base speed to measure it.
  // every pass after that: drive at FAST_MULTIPLIER speed, then ease back to base speed
  // once SLOWDOWN_START_FRACTION of the known length is covered, so it doesn't blow past the tape.
  double slowdownStart = fieldLength * SLOWDOWN_START_FRACTION;
  int stepSpeed = speed;

  while (!seesBoundaryTape() and !(scoopDetect(SCOOP_DETECT_MIN,SCOOP_DETECT_MAX,run_state)) and !(disposalSignalDetect(run_state)))
  {
    stepSpeed = speed;
    if (allowFastRamp and fieldLengthKnown and traveledDistance() < slowdownStart)
    {
      stepSpeed = speed * FAST_MULTIPLIER;
    }
    driveStep(stepSpeed);
  }
  double distance = traveledDistance();
  finishDrive(stepSpeed);

  if (run_state != 2 and run_state != 4) // stopped because of green tape specifically, not an object or the blue return-signal
  {
    snapHeadingToGrid();

    // capture the field's length the first time a row completes cleanly (reached
    // green tape, wasn't cut short by an object) -- this is how big the box
    // actually is this run, since it varies and can't be hardcoded
    if (!fieldLengthKnown)
    {
      fieldLength = distance;
      fieldLengthKnown = true;
    }
  }
}

void driveBlind(double distance, int speed)
  // drives a fixed distance with no scoopDetect check, used to clear the
  // distance sensor away from a just-compacted spot before re-arming detection
{
  LeftMotor.resetPosition();
  RightMotor.resetPosition();

  while (traveledDistance() < distance)
  {
    driveStep(speed);
  }
  finishDrive(speed);
}

void pathFind(int & run_state)
{
  static int row = 0; // persists across calls so we resume where we left off after a scoop/compress
  static bool turnedForShift = false; // true once this row's first turn has run, so resuming after an
                                       // object interrupts the shift drive doesn't repeat that turn

  for (;; row++) // search indefinitely -- only a detected object breaks this loop
  {
    if (!turnedForShift)
    {
      driveUntilGreen(PATH_SPEED, run_state, true); // searching a full row -- fast ramp applies
      if (run_state == 2) return; // object detected mid-row; scoopermove/compress will run, then we resume this row
      if (run_state == 4) return; // blue return-signal seen; goToDisposalBox will head to the red disposal tape

      lastTurnSign = (row % 2 == 0) ? -1 : 1; // alternate direction each row transition (L-L, R-R, L-L, ...)
      rotateRobot(lastTurnSign * TURN_ANGLE, PATH_SPEED);
      turnedForShift = true;
    }

    straightDrive(SHIFT_DISTANCE, PATH_SPEED, run_state);
    if (run_state == 2) return; // object detected mid-shift; resumes here next time, skipping the turn above

    rotateRobot(lastTurnSign * TURN_ANGLE, PATH_SPEED);
    turnedForShift = false;
  }
}

void spinCompressorTo(double degree, int speed, double current_max, directionType dir)
  // ***** COMPRESSOR DISABLED -- MOVEMENT-ONLY TEST BUILD *****
  // The motor commands below are commented out so the robot can be watched doing
  // pathfinding, scooping and the return-to-disposal run without the compressor
  // actuating. Every caller, wait and drive leg is untouched, so the sequence and
  // its timing are unchanged -- only the compressor stays still.
  //
  // TO RE-ENABLE: delete the printf line, uncomment the block under it, and bump
  // CODE_VERSION off the "TEST" name so the brain screen stops advertising this.
{
  printf("COMPRESSOR SKIPPED (disabled) dir=%s degree=%.0f speed=%d maxAmp=%.2f\n",
         (dir == forward) ? "forward" : "reverse", degree, speed, current_max);

  /*
  MotorCompress9.resetPosition();
  MotorCompress9.spin(dir, speed, percent);
  while (fabs(MotorCompress9.position(degrees)) <= fabs(degree) and MotorCompress9.current(amp) <= current_max)
  {}
  MotorCompress9.stop(brake);
  */
}

void compress(double degree, int speed, double current_max, int & run_state)
  // push-inward step stops at whichever comes first: the current threshold (Jintai's
  // idea -- resistance sensed) or the same degree magnitude as the extend step, so the
  // compressor can't keep spinning past where it started if current never spikes
{
  spinCompressorTo(degree, speed, current_max, reverse); // extend/open the compressor arm over the trash
  wait(1, seconds);
  spinCompressorTo(degree, speed, COMPRESS_PUSH_CURRENT_THRESHOLD, forward); // push inward, capped at the same |degree|

  preReturnHeading = totalHeadingDeg; // capture before any return-trip turning begins,
                                       // so returnToSearch() can restore it later

  run_state = 4; // head to the disposal box
}

void dumpTrash()
{
  moveScooperTest(forward, SCOOPSPEED, 2); // bring the scooper down

  spinCompressorTo(COMPRESS_DEGREE, COMPRESS_SPEED, COMPRESS_CURRENT_MAX, reverse); // push all the trash out
  wait(1, seconds);
  spinCompressorTo(COMPRESS_DEGREE, COMPRESS_SPEED, COMPRESS_CURRENT_MAX, forward); // retract back
}

void returnToSearch(int & run_state)
  // retraces goToDisposalBox()'s fixed E-then-N trip, then restores whatever heading
  // pathFind left the robot at before this trip began (preReturnHeading) -- simpler
  // and more robust than reversing each turn individually, since it works regardless
  // of whether the robot was heading N, S, or mid-shift when it stopped to scoop.
  //
  // The two legs deliberately use different mechanics: the N-leg backs straight out
  // of the dump zone (drives in reverse, still facing N, no turn) since that's the
  // quickest way off the tape it just dumped on. The E-leg instead turns to face W
  // first and drives forward the rest of the way, rather than continuing to reverse
  // -- facing the actual direction of travel for the longer leg back toward the row.
{
  driveBlind(lastNorthLegDistance, -PATH_SPEED); // back south, away from red -- still facing N

  rotateToAbsoluteHeading(-90, PATH_SPEED); // turn to face W, the direction of travel for this leg
  driveBlind(lastEastLegDistance, PATH_SPEED); // drive forward, back toward the row

  rotateToAbsoluteHeading(preReturnHeading, PATH_SPEED); // restore the heading pathFind left off at

  run_state = 1; // resume pathFind() -- it picks back up mid-row since turnedForShift was never set for this row
}

void goToDisposalBox(int & run_state)
  // Fixed absolute-heading return: always turn to face E (regardless of which
  // direction the robot was searching in), drive to the E wall, then turn to face N
  // and drive until the red dump zone is found in the corner. No conditional turn
  // direction or memory of where red was previously found needed -- the dump zone's
  // location is fixed, so the route there is fixed too.
{
  static int phase = 0; // 0 = face E and drive to the E wall, 1 = face N and drive to red

  if (phase == 0)
  {
    rotateToAbsoluteHeading(90, PATH_SPEED); // face E

    LeftMotor.resetPosition();
    RightMotor.resetPosition();

    while (!seesGreenTape() and !(scoopDetect(SCOOP_DETECT_MIN, SCOOP_DETECT_MAX, run_state)))
    {
      driveStep(PATH_SPEED);
    }
    finishDrive(PATH_SPEED);
    if (run_state == 2) return; // object detected; resumes this phase next time
    lastEastLegDistance = traveledDistance();

    phase = 1;
  }

  if (phase == 1)
  {
    rotateToAbsoluteHeading(0, PATH_SPEED); // face N

    LeftMotor.resetPosition();
    RightMotor.resetPosition();

    while (!seesRedTape() and !(scoopDetect(SCOOP_DETECT_MIN, SCOOP_DETECT_MAX, run_state)))
    {
      driveStep(PATH_SPEED);
    }
    finishDrive(PATH_SPEED);
    if (run_state == 2) return; // object detected; resumes this phase next time
    lastNorthLegDistance = traveledDistance();

    dumpTrash();
    phase = 0;
    returnToSearch(run_state);
  }
}

int main()
{
  configureAllSensors();
  int run_state = 1;
  /*
    0 close program
    1 run pattern
    2 run scooping
    3 run compress
    4 go to disposal box and dump
  */

  Brain.Screen.clearScreen();
  Brain.Screen.setCursor(1,1);
  Brain.Screen.print("Code %s", CODE_VERSION);
  Brain.Screen.setCursor(2,1);
  Brain.Screen.print("Press to start");

  while (!Brain.buttonCheck.pressing())
  {}
  while (Brain.buttonCheck.pressing())
  {}

  while (run_state != 0)
  {
    userInter(run_state);

    if (run_state == 1)
    {
      pathFind(run_state);
    }
    else if (run_state == 2)
    {
      scoopermove(run_state);
    }
    else if (run_state == 3)
    {
      compress(COMPRESS_DEGREE, COMPRESS_SPEED, COMPRESS_CURRENT_MAX, run_state);
    }
    else if (run_state == 4)
    {
      goToDisposalBox(run_state);
    }
  }

  userInter(run_state);
  Optical11.setLight(ledState::off);
  Brain.programStop();
  return EXIT_SUCCESS;
}
