jintai522/ME101_Wall-E/(commit log)

2026-06-29 Create Vex iq Cad Parts (link)
2026-07-23 Integrate VEXcode robot configuration and sensors
    Added VEXcode generated robot configuration and sensor initialization.
2026-07-23 Wire up state 3 (compress) using current-sensing stall detection
    Adds compress() ported from the compression test project, driven by
    MotorCompress9 with a max-travel/overcurrent cutoff, and hooks it into
    the run_state == 3 branch of main() which previously did nothing.
2026-07-23 Merge partner's scoop/compress tuning and make pathFind scoop-aware
    Folds in partner's cleanup (constants consolidated to top, ROTATE_KP
    rename, slower/gentler scoopermove backup, simplified signature) while
    keeping the hardware-confirmed compress direction. pathFind() now
    reuses straightDrive() (dropping the duplicate pathDrive) so scoop
    detection interrupts the zigzag mid-row; a static row index lets it
    resume from where it left off after a scoop/compress cycle completes
    and hands run_state back to 1 instead of ending the program.
    Also swaps the long forward legs from a fixed 1000mm distance to
    driveUntilGreen(), which drives until the optical sensor reads green
    above a brightness thresho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
2026-07-27 Simplify scoop to single trigger, add odometry-based return-to-start
    Drops the scoop-3-times counter back to a single scoopermove() call
    per detection. Renames the optical sensor to Optical11 (port 11) and
    turns its light on. Widens green-tape hue range to include 80 and
    adds a live hue/brightness/color readout plus status text (Searching/
    Scooping/Compressing/Returning to start/Finished) to the brain screen,
    throttled so it doesn't slow the drive loop.
    Adds simple dead-reckoning odometry (trackMove/totalHeadingDeg/posX/
    posY updated by every drive and rotate call) and a returnToStart()
    function: after one scoop+compress cycle, the robot now drives back to
    its exact starting position and he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
2026-07-27 Remove odometry tracking and related functions
    Removed dead-reckoning odometry functions and related variables.
2026-07-28 Refactor motor and function parameters for clarity
2026-07-29 Enhance straightDrive with direction and power limits
    Refactor straightDrive function to include direction handling and power clamping.
2026-07-29 Add robot configuration and control logic
    This file contains the complete robot configuration and control logic for the VEX-E project, including sensor initialization, motor control, and state management.
2026-07-29 Refactor motor configurations and add door control
    Updated motor configurations and adjusted parameters for motor operations. Added movedoor function for door control and modified compress function logic.
2026-07-29 Modify motor settings and drive parameters
    Updated motor configurations and adjusted rotation and drive parameters for improved robot performance.
2026-07-29 Remove screen clearing in motor operation loop
    Removed screen clearing during motor operation for better display continuity.
2026-07-29 Modify motor configurations and add scoop count
2026-07-29 Replace break with scoopRobot call in run_state 2
    [COPY_PASTE_THIS_Sam_did_something.cpp]
2026-07-29 Reverse motor direction in compressRobot function
    [COPY_PASTE_THIS_Sam_did_something.cpp]
2026-07-29 Fix drive and rotation parameters in robot control
    [COPY_PASTE_THIS_Sam_did_something.cpp]
2026-07-29 v18: current-sensing compress + fixed-maneuver return
    compress() now pushes inward until current crosses
    COMPRESS_PUSH_CURRENT_THRESHOLD (adopted from Jintai's current-sensing
    compress) instead of a fixed degree target. goToDisposalBox() now uses
    a fixed turn/tape-crossing maneuver (adopted from Jintai's returning()
    idea) instead of odometry-vector navigation.
    [AutonomousRobotCode.cpp]
2026-07-30 Refactor moveDoor and compressRobot functions
    Refactor moveDoor function and update print statements for clarity. Remove unused dump function and adjust compressRobot logic.
2026-07-30 Update MotorCompress9 position threshold in loop
2026-07-30 Modify scoopDetect and motor control parameters
    Updated scoop detection and motor control logic for improved performance.
2026-07-30 v9: Add disposal box navigation with odometry-based field length detection
    After compressing, the robot now heads to a disposal box instead of just
    returning home. fieldLength is measured at runtime the first time a row
    completes cleanly against green tape (box size varies, can't be hardcoded).
    goToDisposalBox() computes the vector to (X=0, Y=fieldLength/2), turns to
    absolute right, drives until red tape, then dumpTrash() lowers the scooper
    and cycles the compressor out-then-back to eject the trash. returnToStart()
    is removed in favor of this.
2026-07-30 v10: Improve rotateRobot precision and fix compressor push direction
    rotateRobot() now settles briefly after the main P-loop stops, then applies
    small corrective nudges (lower power floor than the main loop's minimum)
    until it's genuinely within tolerance -- motor momentum was carrying the
    robot past the target after stop(brake) fired. Also swapped dumpTrash()'s
    compressor directions: reverse pushes the arm out to eject trash, forward
    retracts it back to the compact resting position (opposite of what it was).
2026-07-30 v14: Move speed ramp slowdown point to 80% of known field length
    Renamed SLOWDOWN_FRACTION -> SLOWDOWN_START_FRACTION and switched from
    "last 10%" framing to "starts slowing at 80% covered", per request.
2026-07-30 v15: Fix heading drift by holding an absolute heading reference
    BrainInertial.resetRotation() now only happens once, at program start,
    instead of at the start of every drive leg. Previously each leg silently
    redefined "straight" as whatever direction the robot happened to be
    facing right then, so any small misalignment became the new baseline for
    the next leg and compounded over the whole zigzag search. driveStep() now
    corrects toward totalHeadingDeg (a persistent expected heading, updated by
    every rotateRobot call) instead of a hardcoded 0. totalHeadingDeg is kept
    unwrapped so it stays on the same scale as the never-reset inertial
    reading. Added snapHeadingToGrid(): every time the robot rea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
2026-07-30 v16: Widen detection range, smooth stops, and correct heading during scooping
    Three related fixes: (1) SCOOP_DETECT_MAX widened from 30mm to 150mm so
    trash is caught well before the robot is on top of it, both thresholds now
    named constants. (2) finishDrive() now ramps power down in steps before the
    final brake instead of slamming to a stop -- an abrupt stop from the faster
    2x search speed was causing wobble/misalignment right when an object was
    detected. (3) driveStep() is now signed (handles reverse) and a new
    driveForDuration() lets scoopermove() drive heading-corrected for a fixed
    time instead of raw uncorrected equal-percentage motor commands, so a
    misaligned approach doesn't get worse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
2026-07-30 v17: Reduce detection range after false positives from the ground
    SCOOP_DETECT_MAX 150mm -> 60mm. 150 was catching the ground/floor since the
    distance sensor sits slightly angled down; 60 is a middle-ground guess
    between the original too-short 30mm and the too-long 150mm, still needs
    real-world tuning.
2026-07-30 Sync VEX_E.iqcpp to v17 and add project handoff notes
    VEX_E.iqcpp brought in line with COPY_PASTE_THIS.cpp's final v17 state.
    CLAUDE.md documents the current architecture, the VEXcode autosave-clobber
    gotcha and sync workflow, version marker convention, and open items --
    written for continuing this project on a different machine/session.
2026-07-30 Add AutonomousRobotCode.cpp as a new file alongside COPY_PASTE_THIS.cpp
    Same content as the current COPY_PASTE_THIS.cpp (v17), committed under a
    new filename so it doesn't conflict/overwrite the file teammates are also
    editing in parallel.
    [AutonomousRobotCode.cpp]
2026-07-30 Adjust motor parameters and wait times
    Updated motor speeds and positions for better performance.
2026-07-30 Add wait time before stopping MotorCompress9
2026-07-30 v21: cap compress push-inward by degree again
    compress()'s push-inward step was spinning past where the extend
    step started because spinCompressorUntilCurrent() had no degree
    cap -- now uses spinCompressorTo() again (degree AND current
    threshold) so it retracts/pushes the same |degree| (4000) as the
    extend step, not an unbounded spin waiting for a current spike.
2026-07-31 v22: full debug pass
    Fixed pathFind()/goToDisposalBox() double-turning the heading when
    an object interrupts them mid-maneuver and they get resumed (a
    static guard now prevents the turn from re-running). Removed dead
    odometry code (posX/posY/trackMove/PI) left over from the
    goToDisposalBox rewrite -- it ran trig on every finishDrive() call
    for values nothing read anymore.
    [AutonomousRobotCode.cpp]
2026-07-31 v23: loop back to search after dumping
    Adopted Jintai's loop-back-to-search idea. goToDisposalBox() now
    calls returnToSearch() after dumpTrash() instead of ending the
    program (run_state = 0 is no longer reachable) -- it retraces the
    trip to the box in reverse using distances measured on the way
    there (lastCrossDistance/lastEdgeDistance) and resumes pathFind().
    [AutonomousRobotCode.cpp]
2026-07-31 v24: distance-based scoopermove (Jintai's scoopRobot)
    Swapped in Jintai's scoopRobot strategy for scoopermove() --
    distance-based legs instead of timed ones, a fast burst then an
    encoder-limited creep into the object, and a heading restore
    before reversing out (via new realignToIntendedHeading()).
    Compression is untouched and keeps this file's direction
    convention: MotorCompress9 declared un-reversed, extend on
    `reverse`, push inward on `forward`. Jintai's file flips the motor
    declaration and so runs those the opposite way -- do not mix the
    two. driveForDuration() removed (scoopermove was its only caller).
    [AutonomousRobotCode.cpp]
2026-07-31 v25: fix blue/red hue overlap
    BLUE_HUE_MAX 359 -> 260. It overlapped RED_HUE_MIN (340), so the
    red disposal tape satisfied seesBlueTape() as well as
    seesRedTape(). driveUntilRed() was fine (it only checks red), but
    disposalSignalDetect() runs on every step of the search loop, so
    passing near the red tape while searching falsely fired the
    go-home trigger.
    Also corrected the attribution in these comments: the teammate's
    code referred to throughout (COPY_PASTE_THIS_Sam_did_something.cpp,
    despite the filename) is Jintai's.
    [AutonomousRobotCode.cpp]
2026-07-31 v26: TEST BUILD - disable compressor motion
    Compressor motion commented out inside spinCompressorTo() so the
    drive sequence (pathFind, scoop, goToDisposalBox, returnToSearch)
    can be watched on its own. Scooper, drivetrain, state machine and
    all timing are unchanged. NOT for a real run: nothing gets
    compressed or ejected, so the robot never actually empties.
2026-07-31 v27: TEST BUILD - disable scooper, second-green disposal detection
    Scooper motion also disabled (new moveScooperTest(), used by
    scoopermove()'s lower/raise and dumpTrash()'s lower) -- it now
    never actually drops or lifts, only the drivetrain moves. This is
    drivetrain-only now: nothing in the whole cycle actuates except
    wheels.
    Also swapped the disposal-zone detection to Jintai's approach:
    goToDisposalBox()'s final leg now stops on a SECOND green tape
    instead of a dedicated red one -- seesRedTape()/driveUntilRed()/
    RED_HUE_MIN/MAX/RED_BRIGHTNESS_MIN removed, since nothing else in
    the file used them.
    [AutonomousRobotCode.cpp]
2026-07-31 v28: driveUntilGreen gains allowFastRamp parameter
    SLOWDOWN_START_FRACTION is a fraction of a full ROW's length, so
    on goToDisposalBox()'s shorter return-trip legs the robot never
    covered enough distance to trigger the ease-back before hitting
    the tape -- it stayed at FAST_MULTIPLIER (2x) the whole leg. Both
    return-trip calls now pass false and drive at normal PATH_SPEED;
    pathFind()'s row search passes true.
    [AutonomousRobotCode.cpp]
2026-07-31 v29: TEST BUILD - rework return trip via start-column edge
    Reworked the whole return trip. After compressing, the robot no
    longer continues forward in its approach heading (removed
    compress()'s clear-drive) -- it immediately turns toward the start
    column (same direction it already searched, away from any
    unscooped trash still ahead), drives a forced minimum
    SHIFT_DISTANCE, then drives until hitting the start-column edge.
    Red re-introduced (seesRedTape/RED_HUE_MIN/MAX/RED_BRIGHTNESS_MIN)
    to mark the actual dump-zone segment on that edge -- if the first
    contact is red, dump immediately and set hasSeenRed; if green,
    turn along the edge (right if hasSeenRed, left otherwise) and
    search it for red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
    [AutonomousRobotCode.cpp]
2026-07-31 v30: TEST BUILD - fixed absolute-heading NE-corner return
    v29's return trip assumed the dump zone was on the same edge as
    the "turn toward already-covered ground" safety turn -- it wasn't;
    the dump zone is a fixed NE-corner spot (where the E wall meets
    the N wall, N = totalHeadingDeg 0). Replaced with a fixed
    absolute-heading trip: always face E (new rotateToAbsoluteHeading())
    and drive to the E wall, then always face N and drive until red is
    found in the corner, then dump. No conditional turn direction or
    hasSeenRed memory needed anymore -- the destination is fixed, so
    the route is fixed too. Removed driveToStartEdge()/hasSeenRed/
    lastSearchTurnSign/lastShiftEdgeDistance/lastAlongEdgeDistan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
    [AutonomousRobotCode.cpp]
2026-07-31 v31: TEST BUILD - E leg no longer checks red
    Red only runs along the N wall, not the E wall -- the E leg in
    goToDisposalBox() no longer checks for red (it physically can't be
    there), removing the "caught the corner early" early-dump branch
    that assumed otherwise.
    [AutonomousRobotCode.cpp]
2026-07-31 v33: TEST BUILD - E leg faces travel direction on return
    returnToSearch()'s E-leg no longer reverses -- it now turns to face
    W (from wherever the N-leg reverse left it, still facing N) and
    drives forward the rest of the way back toward the row, instead of
    continuing to back up the whole trip. The N-leg (backing straight
    out of the dump zone, still facing N) is unchanged.
    [AutonomousRobotCode.cpp]
2026-07-31 Update VEX_E.iqcpp to v33
    Embeds the current AutonomousRobotCode.cpp (v33) as the app's
    textContent so it opens directly in VEXcode IQ. Also fixes
    MotorCompress9's robotConfig reversed flag (was true, now false)
    to match v33's declared motor(PORT9, false) -- the two were out of
    sync, which would have shown a contradiction between the Devices
    panel and the code, and risked silently flipping the motor if the
    panel was touched in the app.
